greenbuckwheat/Intelligent-Airflow-Control-for-Realistic-Breathing-Simulation/实验/flow_control_exp/analysis/PPV_吸气实验详细报告.md

# PPV 吸气实物实验详细报告

日期：2026-10-06

## 1. 实验与数据范围

本次共复核 40 份 CSV。文件名按实验约定解析：`3.2.csv` 是 3.0 V 的第 2 次重复，`32.csv` 才是 3.2 V；`35.2.csv` 是 3.5 V 的第 2 次重复。

- `37.csv` 的文件名表示 3.7 V，但遥测目标电压全程为 0 V，按用户要求不纳入拟合。
- `42.csv` 证实 4.2 V 已完全夹闭，作为夹闭边界，不拟合有限时间常数。
- 其余 38 次实验纳入动态分析，共 16 个电压点（0–4.1 V）。

## 2. 数据质量审查

- 有效采样间隔的中位数均为 20 ms，即约 50 Hz。操作事件行会产生少量重复时间戳，但积分中对应 `dt=0`，不会增加体积。
- 所有文件的 SFM3300 状态均为 `OK`，故障均为 `NONE`，VAC 全程关闭。
- 压力两列均未记录数值，因此本批数据只能识别整个“阀门—管路—fake lung”的有效动态，不能把阀阻、顺应性和驱动压差分别识别出来。
- 除 `37.csv` 外，各试验在 ATM 打开前 PPV 至少已在目标电压稳定 1.62 s。`35.2.csv` 和 `35.3.csv` 虽在开始记录后才设置 3.5 V，但 ATM 打开前已分别稳定 3.26 s 和 3.77 s，因此操作顺序本身不构成剔除理由。
- 38 次有效动态拟合的决定系数为 0.9961–0.99995，中位数为 0.99937。对“累积吸入体积”而言，一阶曲线描述效果很好。由于积分会平滑流量噪声，该高 \(R^2\) 不等于瞬时流量也以同样精度被拟合。

## 3. 一阶模型与拟合方法

先使用 ATM 打开前最后 2 s 流量的中位数作为零点，对校正后流量进行梯形积分。对每个试验拟合：

\[
V(t)=V_\infty\left[1-\exp\left(-\frac{\max(t-t_d,0)}{\tau_{\mathrm{eff}}}\right)\right]
\]

其中：

- \(V_\infty\) 是本次手动压缩后的可恢复体积；
- \(t_d\) 吸收方向阀、管路、PPV 和传感器的综合延迟；
- \(\tau_{\mathrm{eff}}\) 是该 PPV 电压下实际观测到的有效吸气时间常数。

全开时 \(\tau_{\mathrm{eff}}\) 可视为系统的基础 \(\tau_{in}\)；部分夹闭后，\(\tau_{\mathrm{eff}}\) 同时包含 PPV 造成的减速。

## 4. 分电压结果

| PPV/V | n | \(\tau_{eff}\) 中位数/s | 单次范围/s | 峰值流量中位数/SLM | 拟合终值体积中位数/mL |
|---:|---:|---:|---:|---:|---:|
| 0.00 | 1 | 1.91 | 1.91–1.91 | 51.7 | 1602 |
| 1.00 | 2 | 1.81 | 1.76–1.85 | 47.9 | 1569 |
| 2.00 | 2 | 1.81 | 1.72–1.90 | 61.7 | 1674 |
| 3.00 | 3 | 2.02 | 1.93–2.28 | 48.5 | 1569 |
| 3.10 | 1 | 1.76 | 1.76–1.76 | 53.0 | 1571 |
| 3.20 | 2 | 2.05 | 1.92–2.18 | 41.2 | 1528 |
| 3.30 | 2 | 2.56 | 2.19–2.92 | 39.7 | 1539 |
| 3.40 | 2 | 2.23 | 2.16–2.31 | 37.7 | 1513 |
| 3.50 | 5 | 2.39 | 2.04–2.99 | 35.5 | 1375 |
| 3.60 | 4 | 2.72 | 2.62–3.61 | 23.0 | 1396 |
| 3.70 | 2 | 3.29 | 3.25–3.33 | 16.3 | 1291 |
| 3.75 | 3 | 3.76 | 2.97–3.77 | 17.9 | 1342 |
| 3.80 | 3 | 3.44 | 3.23–3.51 | 16.5 | 1323 |
| 3.85 | 2 | 3.77 | 3.62–3.92 | 18.4 | 1078 |
| 3.90 | 2 | 4.67 | 4.62–4.72 | 12.4 | 1245 |
| 4.00 | 1 | 5.38 | 5.38–5.38 | 13.1 | 1193 |
| 4.10 | 1 | 9.41 | 9.41–9.41 | 5.57 | 837 |
| 4.20 | 1 | 夹闭 | — | 净流量约 0 | — |

电压点之间存在局部非单调，例如 3.3→3.4 V 和 3.75→3.8 V。这与手动初始压缩、软管的机械滞回及重复次数有限相符；不应把单个局部起伏解释成阀门特性反转。整体趋势很清楚：0–约 3.1/3.2 V 为近似平台，3.3 V 后进入有效调节区，3.9 V 以上时间常数快速增加，4.2 V 夹闭。

## 5. \(\tau_{in}\) 的初步识别

0–3.2 V 的 11 次试验中，\(\tau\) 的中位数为 1.91 s，平均值为 1.93 s，标准差为 0.17 s，范围为 1.72–2.28 s。分段模型的联合拟合值为 1.882 s。

因此建议作为当前硬件的初步参数：

\[
\boxed{\tau_{in}\approx1.9\ \mathrm{s}}
\]

工程敏感性范围可先取 1.8–2.1 s。这不是严格置信区间，而是结合重复性和模型拟合得到的初步范围。

## 6. PPV 开度和 \(\gamma\)

实验显示了明显的低电压死区和提前夹闭，因此使用如下有效开度比直接使用 \(a=1-U/5\) 更符合实物：

\[
a_{eff}(U)=
\begin{cases}
1, & U\le U_d\\
\dfrac{U_c-U}{U_c-U_d}, & U_d<U<U_c\\
0, & U\ge U_c
\end{cases}
\]

再用

\[
\tau_{eff}=\frac{\tau_{in}}{a_{eff}^{\gamma}}
\]

拟合电压中位数数据。将已确认的夹闭点固定为 \(U_c=4.2\) V，联合拟合得到：

\[
\boxed{\tau_{in}=1.882\ \mathrm{s},\quad U_d=3.088\ \mathrm{V},\quad \gamma=0.653}
\]

该模型对各电压中位时间常数的 \(R^2=0.986\)。在每个电压随机抽取一次已记录重复并重新拟合 2000 次时，经验敏感性范围为：

- \(\tau_{in}\)：1.79–1.94 s；
- \(U_d\)：2.86–3.17 V；
- \(\gamma\)：0.603–0.680。

由于 0、3.1、4.0 和 4.1 V 只有一次数据，上述范围不是正式的 90% 置信区间，只表示已观测重复差异对参数的影响。

### 为什么不再建议 \(\gamma\approx2.6\)

如果仅在 3.4–4.1 V 内对 \(a=1-U/5\) 做局部幂律拟合，时间常数给出 \(\gamma=2.30\)。但该拟合外推到 \(a=1\) 时会预测 \(\tau_{in}=0.146\) s，与实测约 1.9 s 差一个数量级。对 0–4.1 V 全部数据做同一拟合时，\(\gamma=0.765\)，但 \(R^2\) 只有 0.513。

因此，2.30 只是有效调节区内、在错误开度坐标下的局部斜率，不能作为全局物理参数。将时间常数的 2.30 和早期流量的 2.85 简单平均为 2.6 也不够严谨：两者来自同一条流量曲线，并非独立估计，而且 0.1–0.3 s 的早期流量对传输延迟和初始压缩尤其敏感。

## 7. 重复性与异常试验

- `33.csv`：峰值流量 22.1 SLM，而 `33.1.csv` 为 57.3 SLM；\(\tau\) 分别为 2.92 s 和 2.19 s。`33.csv` 后段有低于 -1 SLM 的反向波动。建议标记为低信心度，但保留于敏感性分析。
- `35.2.csv`：峰值流量只有 19.1 SLM，\(\tau=2.99\) s，结尾有短暂约 -3 SLM 波动。稳健拟合仍有 \(R^2=0.9975\)，可保留但权重应降低。
- `35.3.csv`：一阶拟合良好，但记录结束时流量仍约 0.93 SLM，表明记录窗口略短。
- `36.3.csv`：\(\tau=3.61\) s，明显高于同组其余 2.62–2.79 s，是 3.6 V 组重复性差的主要来源。
- `375.csv`：\(\tau=2.97\) s，低于两次重复的 3.76–3.77 s，建议之后补测。
- 3.3、3.5、3.6 和 3.75 V 的重复试验 \(\tau\) 变异系数约为 20.3%、16.1%、15.8% 和 13.1%，是当前主要不确定性。
- 3.7、3.9 V 重复性最好，\(\tau\) 变异系数分别约 1.8% 和 1.4%。

## 8. 物理解释和局限

1. PPV 对输入电压的响应不是 0–5 V 全范围线性开度。0–约 3.1 V 对流动限制很弱，主要调节区被压缩在约 3.1–4.2 V。
2. 峰值流量在 0–3.2 V 间并不单调，例如 2 V 高于 0 V。这不表示 2 V 比 0 V 更开，而是说明峰值流量强烈受每次 fake lung 初始压缩程度影响。
3. 拟合的 \(V_\infty\) 从低电压时约 1.5–1.7 L 下降到 4.1 V 时约 0.84 L。理想情况下，纯阀阻只应改变速度而不应改变最终静态体积。这表明手动初始状态、记录时长、泄漏或材料滞回仍在影响结果。
4. 电压总体按从低到高的顺序试验，电压影响可能与软管慢性、温度和材料历史存在部分混淆。未来应随机化电压顺序，并在上升/下降两个方向扫描以识别滞回。
5. 当前结果足以支持前馈模型的初步参数化，但不宜作为阀门独立流量系数的精确标定。

## 9. 建议的初步参数与软件用法

建议当前采用：

\[
\boxed{\tau_{in}=1.9\ \mathrm{s},\quad U_d=3.1\ \mathrm{V},\quad U_c=4.2\ \mathrm{V},\quad \gamma=0.65}
\]

并在不确定性测试中使用：

\[
\tau_{in}=1.8\text{–}2.1\ \mathrm{s},\qquad \gamma=0.60\text{–}0.70
\]

注意：\(\gamma=0.65\) 必须与上述 \(a_{eff}\) 分段映射一起使用，不能在保持 \(a=1-U/5\) 的同时直接替换原来的 \(\gamma\)。如果现有控制器不方便改写分段函数，最实用的方法是使用电压—有效开度查表，而不是强行用单一全局幂函数。

## 10. 后续实验优先级

1. 使用固定挡块、定容积注射器或位移标记，统一 fake lung 初始压缩体积。
2. 优先补测 3.3、3.5、3.6、3.75、4.0 和 4.1 V，每点至少 3 次；4.0/4.1 V 记录至少 5–6 个预期时间常数。
3. 将电压点随机化，并进行一次升压和一次降压扫描，单独量化 PPV/软管滞回。
4. 同步记录阀前后压差，才能将 PPV 特性与 fake lung 顺应性分离。
5. 在每次实验结束时要求流量连续 2 s 回到零点附近，避免记录过早停止。

## 11. 总结

这组数据虽然受手动初始压缩差异影响，但仍然能得出有意义且内部一致的初步结论：系统全开吸气一阶时间常数约为 1.9 s；PPV 主要在约 3.1–4.2 V 内调节；4.2 V 为实测夹闭点；在分段有效开度坐标下，初步 \(\gamma\) 为 0.65，建议敏感性范围 0.60–0.70。实验已足以支持初步建模和控制器整定，但最终标定应以更一致的初始体积、随机化扫描和压差测量为基础。

## 12. PWM—控制电压扫描的补充结果

`PPV40_PWM扫描_up1` 和 `PPV40_PWM扫描_2` 测量的是 D5 的 1 kHz、12 bit PWM 经外部滤波/电平转换后，在 PPV 控制输入端得到的稳态直流电压。该实验验证的是电气命令链，不是 PPV 机械开度或流量。

第二次完整升/降扫描的 22 个点得到：

- 最小和最大实测电压约为 0.0074 V 和 5.003 V；
- 相对理想电压的平均偏差为 -1.64 mV；
- 平均绝对误差为 4.07 mV，RMSE 为 4.63 mV；
- 最大绝对误差为 7.4 mV，约为 5 V 满量程的 0.148%；
- 线性回归 \(R^2=0.999993\)；
- 同一 PWM 码值的升扫/降扫电压差最大仅 1.0 mV，平均绝对差 0.27 mV；
- 两次升扫之间的平均绝对差约 0.65 mV，最大差 5 mV，出现在 5 V 端点。

这表明 PWM—滤波/放大—PPV 控制电压链路的稳态线性、精度和重复性都很好，电气升降扫滞回在当前万用表分辨率下基本不可见。因此，流量实验中观测到的 0–3.1 V 平台、3.1–4.2 V 调节区和 4.2 V 夹闭，主要应解释为 PPV/软管的机械与气动特性，而不是 PWM 电压输出不线性造成的假象。

本扫描不能识别延迟。每个 CSV 点只保存手动录入的稳态万用表读数和“保存读数”时间；程序虽要求 ACK 后至少等待 1 s，但没有记录 PWM 命令时刻之后的连续电压波形。实际相邻保存点相隔约 13–53 s，其中包含人工观察、录入和点击时间，不是硬件延迟。

若要测量电气延迟，应使用双通道示波器：一通道触发 D5 PWM 命令变化，另一通道测 PPV 控制输入电压，对 0→4.2 V 和 4.2→0 V 阶跃分别测量纯滞后、10–90% 上升/下降时间、±2% 稳定时间和稳态纹波。若要测 PPV 机械/流量延迟，则应在 ATM 已经打开、压差保持恒定时单独对 PPV 做电压阶跃，同步记录命令时刻和流量响应。
