greenbuckwheat/Intelligent-Airflow-Control-for-Realistic-Breathing-Simulation/实验/flow_control_exp/analysis/control_runs/控制运行复核.md

# 控制运行复核

日志：356599273（6BPM/150mL/1循环）、356639792（6BPM/150mL/5循环）、356755311（10BPM/250mL/5循环，截图对应）。

表中积分用50Hz遥测的正/负流量分别进行梯形积分，包含关闭后的测得流量，未扣除泄漏基线。它不等于肺几何体积；与固件100Hz积分会有采样差异。

|文件|循环|阶段|峰值SLM|显示终值mL|方向流量积分mL|关阀后积分mL|
|---|---:|---|---:|---:|---:|---:|
|single_lung_hardware_run_356599273.csv|1|INSPIRATION|26.70|220.2|216.7|64.6|
|single_lung_hardware_run_356599273.csv|1|EXPIRATION|-31.93|0.0|-230.1|-11.9|
|single_lung_hardware_run_356639792.csv|1|INSPIRATION|23.37|212.9|212.4|59.3|
|single_lung_hardware_run_356639792.csv|1|EXPIRATION|-30.40|0.0|-220.9|-12.1|
|single_lung_hardware_run_356639792.csv|2|INSPIRATION|18.50|168.9|168.0|15.9|
|single_lung_hardware_run_356639792.csv|2|EXPIRATION|-40.30|0.0|-204.1|-34.8|
|single_lung_hardware_run_356639792.csv|3|INSPIRATION|18.83|165.0|163.6|13.0|
|single_lung_hardware_run_356639792.csv|3|EXPIRATION|-44.23|0.0|-209.4|-39.8|
|single_lung_hardware_run_356639792.csv|4|INSPIRATION|18.40|163.6|164.7|15.1|
|single_lung_hardware_run_356639792.csv|4|EXPIRATION|-44.77|0.0|-204.6|-41.5|
|single_lung_hardware_run_356639792.csv|5|INSPIRATION|17.60|161.8|160.7|9.5|
|single_lung_hardware_run_356639792.csv|5|EXPIRATION|-46.23|0.0|-199.6|-46.0|
|single_lung_hardware_run_356755311.csv|1|INSPIRATION|35.97|250.0|297.4|46.1|
|single_lung_hardware_run_356755311.csv|1|EXPIRATION|-41.17|0.0|-257.3|-15.2|
|single_lung_hardware_run_356755311.csv|2|INSPIRATION|19.23|250.0|269.8|18.8|
|single_lung_hardware_run_356755311.csv|2|EXPIRATION|-38.87|0.0|-277.9|-36.6|
|single_lung_hardware_run_356755311.csv|3|INSPIRATION|19.97|250.0|266.9|17.1|
|single_lung_hardware_run_356755311.csv|3|EXPIRATION|-39.13|0.0|-283.9|-37.1|
|single_lung_hardware_run_356755311.csv|4|INSPIRATION|19.73|250.0|263.3|13.2|
|single_lung_hardware_run_356755311.csv|4|EXPIRATION|-39.80|0.0|-282.3|-42.8|
|single_lung_hardware_run_356755311.csv|5|INSPIRATION|18.43|250.0|262.7|13.0|
|single_lung_hardware_run_356755311.csv|5|EXPIRATION|-42.03|0.0|-289.3|-43.5|

## 原因与限度

150mL首轮显示终值220.2mL，ATM关闭后的测得正流量积分约64.6mL。10BPM首轮正流量积分约297.4mL，但显示被固件限制在250mL。因此显示250不能证明无超量。
切换时存在短时强流量和关闭后的尾流，符合执行器/阀门/管路动态叠加，但没有阀位或压力反馈，不能独立确定pinch valve动作延迟。命令电压不是实际阀位。
固件达到目标后没有清零opening；方向direction变为0时仍保留opening并按吸气映射重新计算电压。截图末尾opening62.4%并不代表实际阀位，valve_mask为0。
呼气前馈采用当前小体积积分V/tau，但tau来自大体积塌缩实验；强负压小周期下该近似可能偏差很大，不能把跟踪误差全部归结为纯延迟。
建议后续固件处理：关闭方向阀后明确PPV停止目标；切换前预定位并验证等待时间；避免体积截断掩盖超量；根据尾流和小体积工况重新验证停流与前馈。当前本次仅修改User Mode的流量设定方式，没有自动添加未知延迟或启用Smith。

User Mode只设BPM、I:E、目标体积和循环数；吸气参考Q=0.06*V/Ti自动计算。SLM仍是实测及控制参考单位，不是独立用户设定。
