greenbuckwheat/Intelligent-Airflow-Control-for-Realistic-Breathing-Simulation/实验/flow_control_exp/analysis/vac_atm_cycles/参数辨识结论.md

# 0、1、2 V 多循环参考参数

分析文件：00.csv、00.1.csv、00.2.csv、00.3.csv、1.1.csv、2.csv。
全部遥测为 OK/NONE；每个文件 PPV 目标电压恒定，分别为 0、1、2 V。

## 方法与筛选

按遥测 ATM/VAC 状态变更分段，排除操作事件行，用 MCU 时间进行梯形积分。
只扣除记录开始的稳定零点，不扣除 VAC 关闭后的正流量。
本批明显弱响应的单段积分约 29–321 mL，与主要响应的 1.2–1.9 L 有明显分离；
因此以单段绝对积分 >=800 mL 作为本批主要响应筛选，结合曲线检查。
这只是本批经验筛选，不证明阀芯位置，也不适合直接用于高电压或短周期实验。
随后吸气量很小的段也剔除，以避免混入抽气不足造成的初始状态差异。

拟合累计体积：V=A*(1-exp(-max(t-d,0)/tau))，使用稳健损失。
tau 是一阶等效描述，d 是形状拟合参数；不能把 d 当作独立 PPV 延迟。
累计体积拟合的高 R² 不保证瞬时流量是一阶，模型未单独表示泄漏和管路压缩。

## 呼气结果

| PPV目标/V | 总VAC段 | 保留段 | tau中位数/s | 单段范围/s |
|---|---:|---:|---:|---:|
| 0 | 18 | 12 | 1.372 | 1.197–2.014 |
| 1 | 8 | 5 | 1.340 | 1.245–1.436 |
| 2 | 5 | 1 | 1.338 | 单段，不评价重复性 |

可用 tau_out≈1.35 s 作为当前负压条件下的控制模型初值。
0 V 多数结果约1.2–1.6 s，但存在2.01 s段，应保留约1.2–2.0 s的实测敏感性范围，非置信区间。
各段末尾仍有抽气，且部分记录被提前截断；拟合终值不等于测得容量。
当前约1.35 s与此前约1.7 s来自不同记录，不能认为任一数值跨负压条件通用。

## 吸气结果

主要响应段全量拟合的tau中位数：0 V 2.373 s，1 V 2.616 s，2 V 1.925 s。
0 V范围1.697–6.263 s，1 V范围2.127–4.137 s；不少段提前关闭ATM，不能可靠外推终值。
若仅查看末2 s中位流量<=1 SLM的段：0 V四段tau为1.697、1.799、1.931、1.809 s，
中位数1.804 s；1 V只有一段2.127 s；2 V只有一段1.925 s。
这个尾流判据只是减少明显截断影响，不证明已达真正平衡。
更完整吸气段支持约1.8–2.1 s的初值，与此前吸气实验约1.9 s一致。
不足以证明0–2 V存在单调、显著调节，也不足以重新拟合gamma。

## 对幻灯片剩余参数的判断

- 当前负压下tau_out：可得到初步等效值；仍需重复和独立循环验证。
- 独立PPV指令到流量延迟：不能；每个文件PPV固定，未施加PPV阶跃。
- 不同负压下tau_out：不能建立对应关系；CSV不含负压值或设置标签。
- gamma_out及呼气电压映射：0–2 V响应近似平台，需补有效夹紧区。
- 呼吸频率/I:E可行性：可以用模型做初步估计，当前手动长周期不能验证闭环短周期表现。
- 周期一致性：能量化当前开环表现；进出积分持续不闭合，不能声明容量稳定或闭环达标。

建议补：固定负压下至少三次正常2 V循环；约3.2–4.2 V的呼气调节区扫描；
固定方向阀时的PPV阶跃及固件执行时间戳；如需多负压模型，标记每档负压源设置。
无需压力传感器即可做这些经验辨识，但不能识别独立阻力、顺应性、真实容量。

逐段筛选和拟合见 voltage_cycle_segments.csv；汇总见 voltage_cycle_summary.json。
