greenbuckwheat/Intelligent-Airflow-Control-for-Realistic-Breathing-Simulation/实验/flow_control_exp/analysis/today_hardware/今日参数报告.md

# 今日单肺参数辨识与 GUI 兼容性

本报告只分析用户指定的29个文件，以遥测电压而非文件名作分组；全部为OK/NONE。旧报告的参数和日期不作为本批测量值。

## 计算方法与筛选

使用MCU时间，移除操作事件行，以初始稳定流量作为基线。VAC关闭后的正流量保留，不当作零点。标准体积积分为1000/60×积分Qdt。
累计体积模型：V=A[1-exp(-max(t-d,0)/tau)]，采用稳健最小二乘。A是每段可交换气量的等效外推幅度，不等于实际几何容量；d是描述形状的综合参数，不是独立PPV延迟。
0–3.9 V保留积分>=800mL且0.1–0.5s抽气中位数>=30SLM的VAC段；4–4.1 V降低早期流量筛选至8SLM。阈值基于本批正常与弱响应的明显分离，不能用于推断实际阀芯位置。
ATM保留积分>=800mL、末0.5s流量<=1SLM且持续时间>=3tau的段，减少明显截断造成的终值/tau共线性。高电压下仍不能证明初态一致。
4.15V不按800mL规则判半开：VAC近恒定低流量、拟合tau触及100s上界，单指数不可辨识；ATM可得到描述性tau约33.5–36.6s，但其抽气初态不明确，不用于gamma拟合。
4.2V只记录约4.34s VAC及3.82s ATM，流量约零，是短时夹闭观察，不是无限时长零泄漏证明。

## 分电压结果

|PPV/V|吸气保留段|tau_in_eff/s|呼气保留段|tau_out_eff/s|
|---:|---:|---:|---:|---:|
|0|5/14|1.809|12/18|1.372|
|1|10/17|2.552|14/17|1.355|
|2|6/13|2.324|8/12|1.315|
|2.5|4/7|2.610|6/6|1.313|
|3|9/10|2.554|10/10|1.274|
|3.1|8/12|2.536|11/11|1.314|
|3.2|20/28|2.454|27/27|1.308|
|3.3|14/18|2.555|18/18|1.304|
|3.4|17/19|2.429|18/18|1.318|
|3.45|4/11|2.378|10/10|1.248|
|3.5|2/7|2.496|6/6|1.297|
|3.55|7/10|2.879|10/10|1.274|
|3.6|7/14|2.525|13/13|1.261|
|3.65|6/6|2.818|6/6|1.280|
|3.7|8/14|2.916|14/14|1.337|
|3.75|4/8|3.052|8/8|1.333|
|3.8|6/10|3.055|9/9|1.282|
|3.85|9/10|3.222|9/9|1.361|
|3.9|5/8|3.581|7/7|1.375|
|4|5/7|5.098|6/6|1.615|
|4.05|1/6|7.262|5/5|2.234|
|4.1|1/7|13.123|6/6|5.116|
|4.15|0/2|—|0/2|—|
|4.2|0/1|—|0/1|—|

## 可以报告的参数

- 严格0V基准：tau_in=1.809s（5段，1.697–2.277s）；tau_out=1.372s（12段，1.197–2.014s）。这是GUI基础时间常数的直接参考值。
- 加入全批低电压平台后：吸气0–3.4V各电压中位数的中位数为2.536s（93段）；呼气0–3.9V为1.313s（216段）。全批平台拟合tau_in≈2.51s、tau_out≈1.31s。
- 0V吸气比1–3.4V明显快，不能简单认定平台上所有数据同一初态。连续循环、等待时间、塌缩程度及慢尾都影响等效拟合。1.8s与2.5s是不同估计口径，不能同时称为已确定的唯一tau_in。建议敏感性测试1.8–2.8s，再用固定初态循环确认。
- 低电压吸气平台等效拟合幅度约1538mL；呼气约1705mL。不闭合且高电压幅度变化，不能确定真实容量。若采用约1500mL，只能标为模型有效幅度，不能当作已验证几何容量或安全体积上限。
- flow_sign=+1（ATM正、VAC负）。
- 4.2V短时未观察到流量；4.15V仍有流量，因此目标电压夹闭点在(4.15,4.2]V内，实际模拟电压仍需电气校准。

## gamma与电压映射

经验形式：a_eff=1（U<=Ud）；a_eff=(Uc-U)/(Uc-Ud)（Ud<U<Uc）；a_eff=0（U>=Uc），tau=tau0/a_eff^gamma。两方向独立拟合。
自由拟合Uc触及下界约4.151V，提示Uc/gamma高度相关，不能把最佳拟合小数当成精确物理参数。固定Uc敏感性如下：

|方向|假设Uc/V|tau0/s|Ud/V|gamma|
|---|---:|---:|---:|---:|
|inspiration|4.150|2.509|3.680|0.696|
|inspiration|4.175|2.530|3.727|0.854|
|inspiration|4.200|2.530|3.733|0.961|
|expiration|4.150|1.311|3.974|1.065|
|expiration|4.175|1.311|3.978|1.381|
|expiration|4.200|1.311|3.980|1.686|

用Uc=4.20V时，吸气描述性gamma≈0.96、Ud≈3.73V；呼气gamma≈1.69、Ud≈3.98V。应优先采用两方向电压—相对导通查表k(U)=tau0/tau(U)，不要取两个gamma的平均值。

## 当前GUI/固件不能直接准确承接这些参数

single_lung_controller_stm32.ino的writePinchCommand使用U=5(1-opening)，updateSmith和前馈使用opening^gamma，吸呼气共用gamma。此形式预测整个0–5V连续幂律调节，不能描述实测平台和4.2V提前夹闭。
按现有形式拟合全扫描：吸气tau0≈1.492s、gamma≈0.638；呼气tau0≈1.064s、gamma≈0.269。它们只是错误映射下的折中，明显漏掉4.1V慢响应，且呼气gamma低于GUI下限0.5，不推荐使用。
GUI容量输入10–250mL，但实测模型幅度约1500mL；不能把参数直接填进去并期待模型前馈正确。250mL目标潮气量与1500mL模型幅度不是一个字段含义。
配置同时有max_lung_volume_ml；GUI会把它设为capacity，因而扩展输入范围并写入1500还会改动软件体积保护。须区分模型幅度、目标体积与经过验证的保护上限。此分析未改GUI、固件或控制配置。

## 未被本批实验识别的参数

- Smith feedback delay：没有独立PPV阶跃或执行时间戳，不能从累计拟合d取得；建议Smith保持关闭。
- validated direction dead time：手动切换和实验固件50ms互锁不证明正式系统最小安全等待时间；不能由本批确定。
- precondition time：只能按目标初态验证选取，含泄漏时不能从3tau直接保证排空。正式固件预处理opening=0.35对应3.25V；应结合实测映射重新核对。
- Kp、Ki、Kd、积分限幅、Smith gain和max flow保护：不是此开环扫描直接辨识出的参数，需要闭环测试/单独验证；开启瞬间有单点约130SLM尖峰，不能用该峰值直接校准增益或设置保护。
- 多负压模型：没有负压值/档位记录；参数只按当前负压条件解释，前提是设置保持一致。

全部逐段结果见screened_segments.csv；数值和敏感性见model_summary.json；每份文件均生成了周期图。
