greenbuckwheat/Intelligent-Airflow-Control-for-Realistic-Breathing-Simulation/实验/flow_control_exp/analysis/today_hardware/screened_segments.csv

file | segment | voltage | state | start_s | end_s | duration_s | min_slm | max_slm | baseline_slm | signed_volume_ml | tail_median_slm | peak_time_from_state_s | fitted_volume_ml | tau_s | apparent_delay_s | cumulative_r2 | cumulative_rmse_ml | early_median_slm | end_last_half_slm | tau_skip_0p1_s | usable | reason
00.csv | 1.0 | 0.0 | 2.0 | 2.8660000000000423 | 6.2660000000000196 | 3.3999999999999773 | -111.633 | 0.033 | 0.033 | -1835.480999999977 | -19.1 | 0.01999999999998181 | 2345.6486840889797 | 2.0136651816149613 | 0.020964775635711315 | 0.9978781317802713 | 25.150475906370183 | 56.716 | 7.2165 | 1.8986780653140645 | True | substantial expiration; tail leakage included in effective fit
00.csv | 3.0 | 0.0 | 1.0 | 14.576000000000079 | 23.156000000000006 | 8.579999999999927 | 0.6 | 23.233 | 0.033 | 1229.1633333333307 | 0.733 | 0.05999999999994543 | 1241.7336910902911 | 1.6971413641456117 | 0.46806362714429245 | 0.9886119097968227 | 38.76861648640622 | 21.334 | 0.5834999999999999 | 1.6641195340438337 | True | substantial inspiration; late tail and fit coverage adequate
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
