greenbuckwheat/Intelligent-Airflow-Control-for-Realistic-Breathing-Simulation/实验/ppv40 specs.png

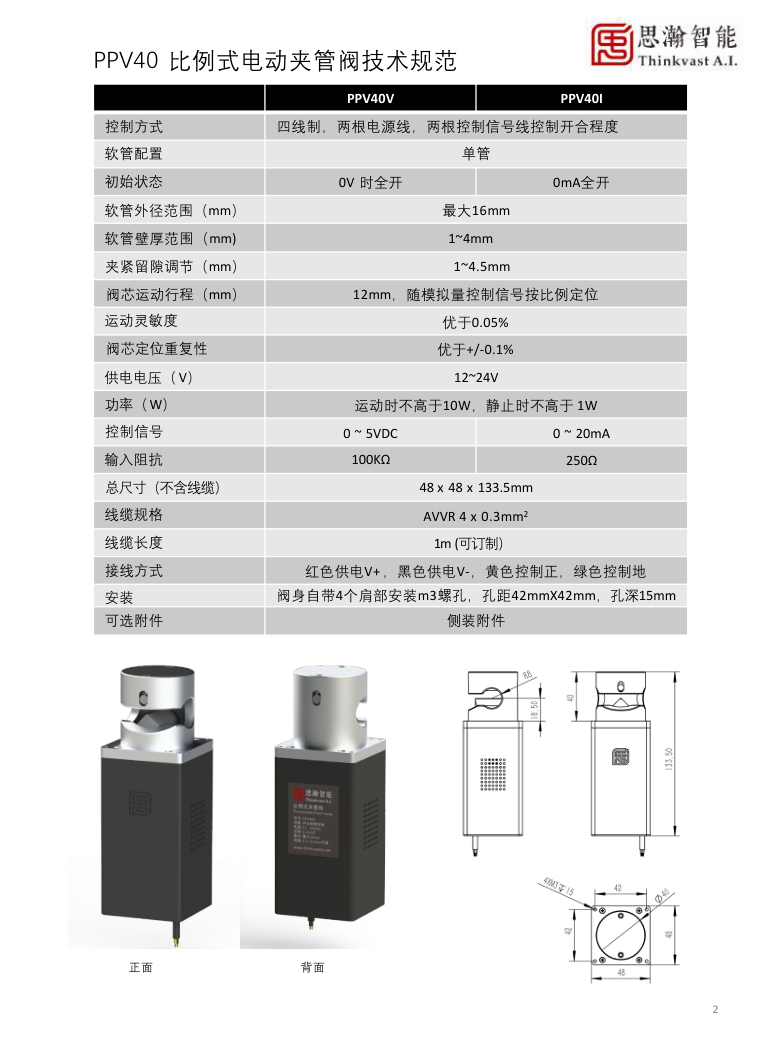
实验/ppv40 specs.png
