greenbuckwheat/Intelligent-Airflow-Control-for-Realistic-Breathing-Simulation/实验/pwm exp UI.png

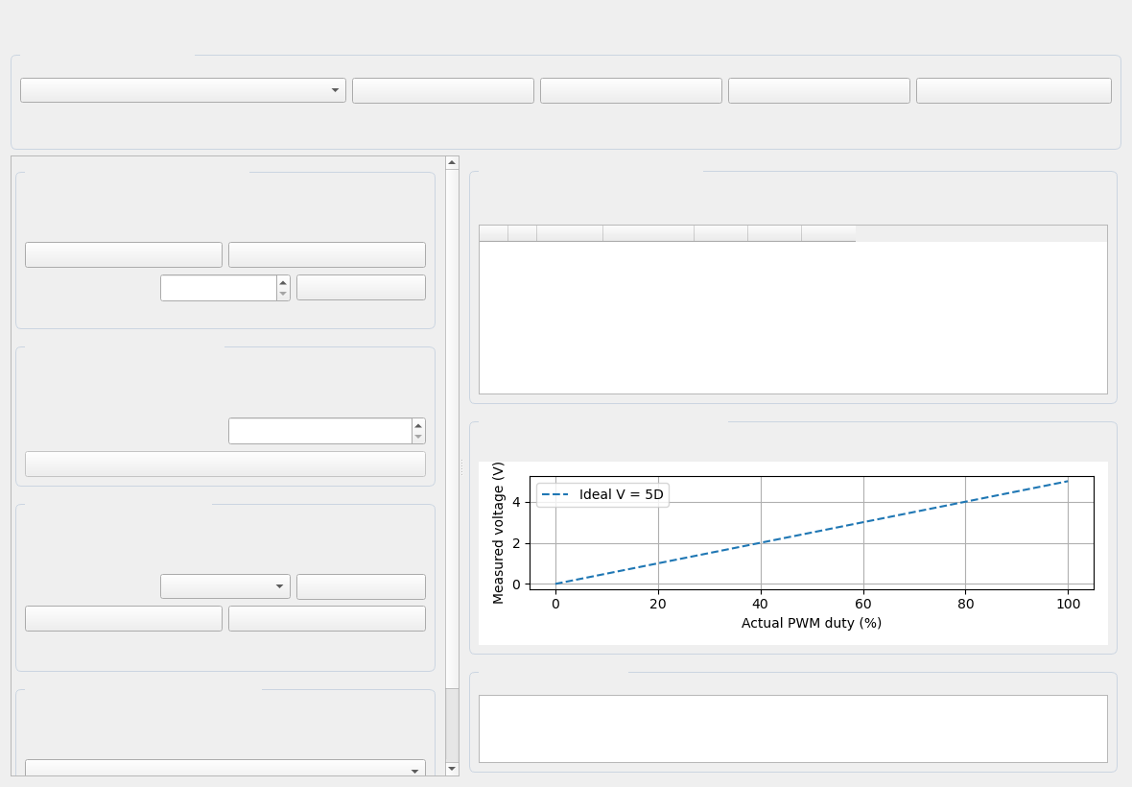
实验/pwm exp UI.png
