greenbuckwheat/Intelligent-Airflow-Control-for-Realistic-Breathing-Simulation/实验/不用数据/_analysis_overview.png

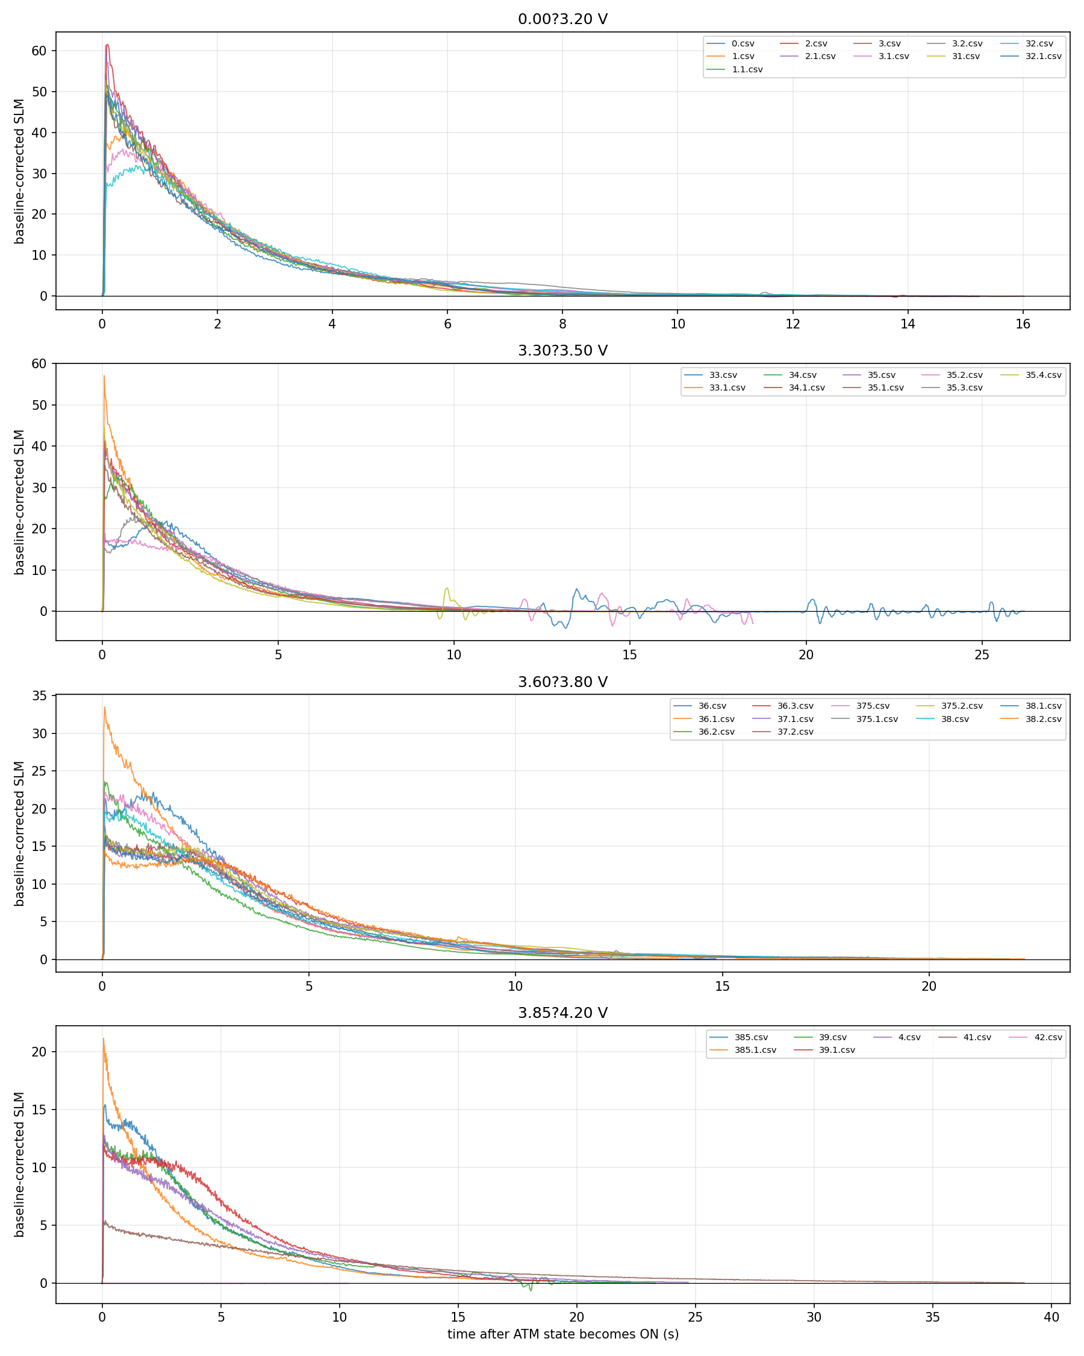
实验/不用数据/_analysis_overview.png
