greenbuckwheat/Intelligent-Airflow-Control-for-Realistic-Breathing-Simulation/LungLogic_DualBranch_PID_Simulation_Arduino/output/calibration_audit/atm_opening_per_cycle.csv

run | cycle | n | duration_s | logged_increment_ml | positive_integral_ml | signed_integral_ml | opening_mean | opening_min | opening_max | command_v_mean | command_v_min | command_v_max | estimated_v_min | estimated_v_max | atm_n | sampled_atm_n
06 | 1 | 83 | 1.6599999999999646 | 124.8 | 125.21733333333064 | 125.19286666666399 | 0.41016867469879503 | 0.175 | 0.474 | 4.267915662650602 | 4.255 | 4.315 | 4.255 | 4.315 | 83 | 83
06 | 2 | 83 | 1.6599999999999646 | 127.2 | 127.46506666666394 | 124.25043333333069 | 0.40844578313253005 | 0.178 | 0.48 | 4.26832530120482 | 4.254 | 4.314 | 4.254 | 4.314 | 83 | 83
06 | 3 | 83 | 1.6599999999999646 | 116.20000000000002 | 117.01729999999752 | 113.31399999999759 | 0.42227710843373484 | 0.181 | 0.487 | 4.265554216867469 | 4.253 | 4.314 | 4.253 | 4.314 | 83 | 83
06 | 4 | 83 | 1.6599999999999646 | 113.8 | 114.15519999999755 | 110.52169999999761 | 0.42632530120481915 | 0.183 | 0.489 | 4.264710843373494 | 4.252 | 4.313 | 4.252 | 4.313 | 83 | 83
06 | 5 | 83 | 1.6599999999999646 | 115.89999999999999 | 116.3773666666642 | 112.94166666666428 | 0.4286746987951808 | 0.185 | 0.491 | 4.264265060240964 | 4.252 | 4.313 | 4.252 | 4.313 | 83 | 83
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
