greenbuckwheat/Intelligent-Airflow-Control-for-Realistic-Breathing-Simulation/LungLogic_DualBranch_PID_Simulation_Arduino/output/calibration_audit/syringe_recomputed.csv

direction | start_s | end_s | ppv_v | measured_ml | error_pct | apparent_gain | applied_gain_volume_ml
positive | 6.28 | 13.64 | 0.0 | 240.57149669907574 | -3.771401320369705 | 1.0391921047601 | 251.9024141936022
negative | 17.96 | 31.72 | 0.0 | 238.69305689593085 | -4.522777241627662 | 1.047370222037916 | 249.93549987572916
positive | 35.42 | 47.36 | 0.0 | 238.88218803264905 | -4.447124786940382 | 1.0465409834819137 | 250.1335390889868
negative | 49.08 | 64.74 | 0.0 | 236.85649207778178 | -5.257403168887286 | 1.0554914404368616 | 248.01243285464528
positive | 78.06 | 94.36 | 3.2 | 239.16298589605086 | -4.334805641579653 | 1.0453122545838232 | 250.42756253175483
negative | 94.94 | 107.98 | 3.2 | 239.10134461649258 | -4.359462153402971 | 1.0455817402490495 | 250.36301794792936
positive | 108.58 | 118.96 | 3.2 | 238.94539797143207 | -4.421840811427169 | 1.0462641344943986 | 250.1997262158865
negative | 119.36 | 127.5 | 3.2 | 237.7719416036489 | -4.891223358540431 | 1.051427676091128 | 248.97100005318075
