greenbuckwheat/Intelligent-Airflow-Control-for-Realistic-Breathing-Simulation/LungLogic_DualBranch_PID_Simulation_Arduino/output/zero_leak_calibration_2026-10-09/leak_windows.csv

phase | from_s | to_s | n | mean_slm | median_slm | std_slm | min_slm | max_slm | p05_slm | p95_slm
VAC | 0.0 | 10.0 | 501 | -10.836646182967158 | -2.636392689953187 | 16.225383142759807 | -61.27039268995319 | -0.003392689953186893 | -48.736392689953185 | -0.9033926899531869
VAC | 10.0 | 20.0 | 500 | -0.8645126899531869 | -0.8363926899531868 | 0.11909185362567833 | -1.0703926899531868 | -0.7033926899531868 | -1.0363926899531868 | -0.7033926899531868
VAC | 20.0 | 30.0 | 500 | -0.8384906899531868 | -0.8033926899531869 | 0.1042019020747702 | -1.0703926899531868 | -0.7033926899531868 | -1.0363926899531868 | -0.7363926899531869
VAC | 30.0 | 40.0 | 499 | -0.8788536117968742 | -0.8363926899531868 | 0.10901230821626141 | -1.0703926899531868 | -0.7363926899531869 | -1.0703926899531868 | -0.7703926899531869
VAC | 40.0 | 50.0 | 500 | -0.9053866899531868 | -0.8703926899531869 | 0.10849483842100505 | -1.103392689953187 | -0.7363926899531869 | -1.0703926899531868 | -0.7703926899531869
VAC | 50.0 | 60.0 | 500 | -0.9067586899531869 | -0.8703926899531869 | 0.11635127865219186 | -1.103392689953187 | -0.7703926899531869 | -1.0703926899531868 | -0.7703926899531869
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
