greenbuckwheat/Intelligent-Airflow-Control-for-Realistic-Breathing-Simulation/LungLogic_DualBranch_PID_Simulation_Arduino/output/zero_leak_calibration_2026-10-09/zero_by_state.csv

atm | vac | ppv_v | n | mean_slm | median_slm | std_slm | min_slm | max_slm | p05_slm | p95_slm
0 | 0 | 0.0 | 2387 | 0.0027235023041474655 | 0.0 | 0.010566752950561371 | -0.033 | 0.033 | 0.0 | 0.033
0 | 0 | 5.0 | 251 | 0.005258964143426295 | 0.0 | 0.0143746356033048 | -0.033 | 0.033 | 0.0 | 0.033
0 | 1 | 0.0 | 1297 | 0.002747879722436392 | 0.0 | 0.010244977582519892 | -0.033 | 0.033 | 0.0 | 0.033
1 | 0 | 0.0 | 1619 | 0.004606547251389747 | 0.0 | 0.013185013358710928 | -0.033 | 0.033 | 0.0 | 0.033
