greenbuckwheat/Intelligent-Airflow-Control-for-Realistic-Breathing-Simulation/LungLogic_DualBranch_PID_Simulation_Arduino/output/zero_leak_calibration_2026-10-09/zero_segments.csv

segment | start_s | duration_s | atm | vac | ppv_v | transient_min_slm | transient_max_slm | n | mean_slm | median_slm | std_slm | min_slm | max_slm | p05_slm | p95_slm
0 | 0.0 | 33.18 | 0 | 0 | 0.0 | -0.033 | 0.033 | 1560 | 0.00275 | 0.0 | 0.01034031505248343 | -0.033 | 0.033 | 0.0 | 0.033
1 | 33.233 | 22.040000000000006 | 1 | 0 | 0.0 | -0.333 | 0.167 | 1003 | 0.00513260219341974 | 0.0 | 0.012750515165956369 | -0.033 | 0.033 | 0.0 | 0.033
2 | 55.328 | 23.22 | 0 | 1 | 0.0 | -11.567 | 20.9 | 1062 | 0.002858757062146893 | 0.0 | 0.01022859316959653 | -0.033 | 0.033 | 0.0 | 0.033
3 | 78.604 | 14.299999999999997 | 1 | 0 | 0.0 | -3.233 | 0.5 | 616 | 0.0037500000000000007 | 0.0 | 0.013820597981687645 | -0.033 | 0.033 | 0.0 | 0.033
4 | 92.924 | 6.959999999999994 | 0 | 0 | 0.0 | -0.9 | 0.3 | 249 | 0.002650602409638554 | 0.0 | 0.011143568824354553 | -0.033 | 0.033 | 0.0 | 0.033
5 | 99.938 | 6.679999999999993 | 0 | 1 | 0.0 | -0.867 | 0.467 | 235 | 0.002246808510638298 | 0.0 | 0.010303828065001816 | -0.033 | 0.033 | 0.0 | 0.033
6 | 106.638 | 9.0 | 0 | 0 | 0.0 | -1.033 | 1.633 | 351 | 0.0016923076923076926 | 0.0 | 0.009819274207221606 | -0.033 | 0.033 | 0.0 | 0.033
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
