greenbuckwheat/Intelligent-Airflow-Control-for-Realistic-Breathing-Simulation/LungLogic_DualBranch_PID_Simulation_Arduino/firmware/single_lung_controller_stm32/flow_calibration.h

#pragma once
#include <math.h>
#include <stdint.h>

static float calibratedFlow(float raw, float offset, float gain, int8_t sign) {
  return sign * gain * (raw - offset);
}

// The 2026-10-12 sweep showed an approximately constant VAC bypass tail from
// 3.80 through 4.30 V.  It disappears only in the final pinch interval near
// 4.35 V, so conductance-power scaling is not physically representative.
static float vacLeakAtVoltage(float plateauLeak, float ppvVolts,
                              float rolloffStartVolts, float closureVolts) {
  if (plateauLeak <= 0.0f || ppvVolts >= closureVolts) return 0.0f;
  if (ppvVolts <= rolloffStartVolts) return plateauLeak;
  if (closureVolts <= rolloffStartVolts) return 0.0f;
  float fraction = (closureVolts - ppvVolts)
                   / (closureVolts - rolloffStartVolts);
  return plateauLeak * fraction;
}

// Net lung-flow estimate. Leakage applies only to active vacuum extraction.
// Limit compensation to measured extraction: never invent positive filling.
static float netLungFlow(float calibrated, uint8_t sampledValveMask, float leak) {
  if (sampledValveMask != 2 || calibrated >= 0.0f) return calibrated;
  float net = calibrated + leak;
  return net < 0.0f ? net : 0.0f;
}
