greenbuckwheat/Intelligent-Airflow-Control-for-Realistic-Breathing-Simulation/(commit log)

2026-10-13 Initial import of breathing simulation controller and experiments
    [0.csv, 00.1.csv, 00.2.csv, 00.3.csv, 00.csv, 02.csv, 02_10bpm.csv, 03.csv]
2026-10-13 Focus repository on single-lung hardware, calibration and experiment data
    [18bpm_30_cycle_tradeoff.csv, breath_summary.csv, controlled_grid.csv, data_inventory.csv, feedback_comparison.csv, fill_curve_sensitivity.csv, installed_path_limits.csv, lung_simulation.csv]
2026-10-13 Update README description of system reuse and calibration
